Wynaan/XES/Programmation Projet/Sprite Image Files/Tileset_40px_packed.png

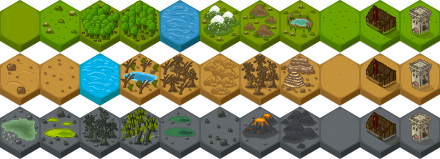
Programmation Projet/Sprite Image Files/Tileset_40px_packed.png
