Wynaan/XES/README.md

# XES

This repository details my end of degree project in Electronics Technology at Cegep Saint-Jean-sur-Richelieu.
