Wynaan/XES/Conception Files/Expansion Board/expansion_board_rev1/botlayer.png

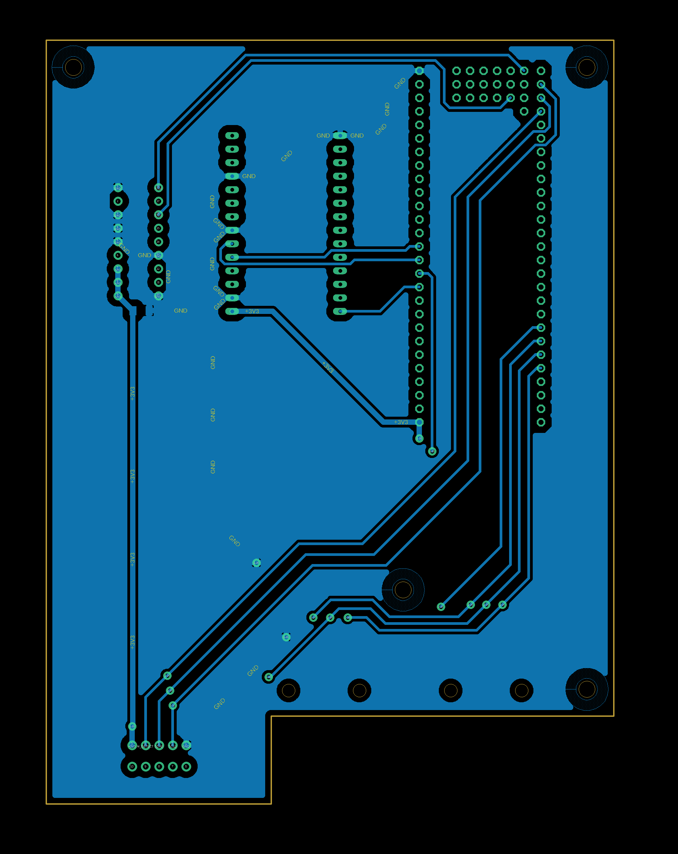
Conception Files/Expansion Board/expansion_board_rev1/botlayer.png
