Wynaan/XES/Conception Files/Expansion Board/expansion_board_rev1/placementbot.png

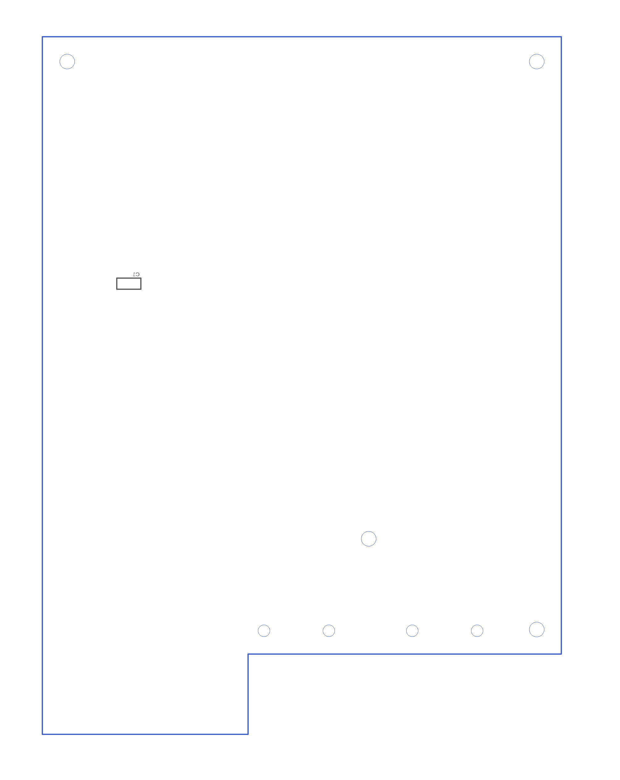
Conception Files/Expansion Board/expansion_board_rev1/placementbot.png
