Wynaan/XES/Conception Files/Expansion Board/expansion_board_rev1/schematic.png

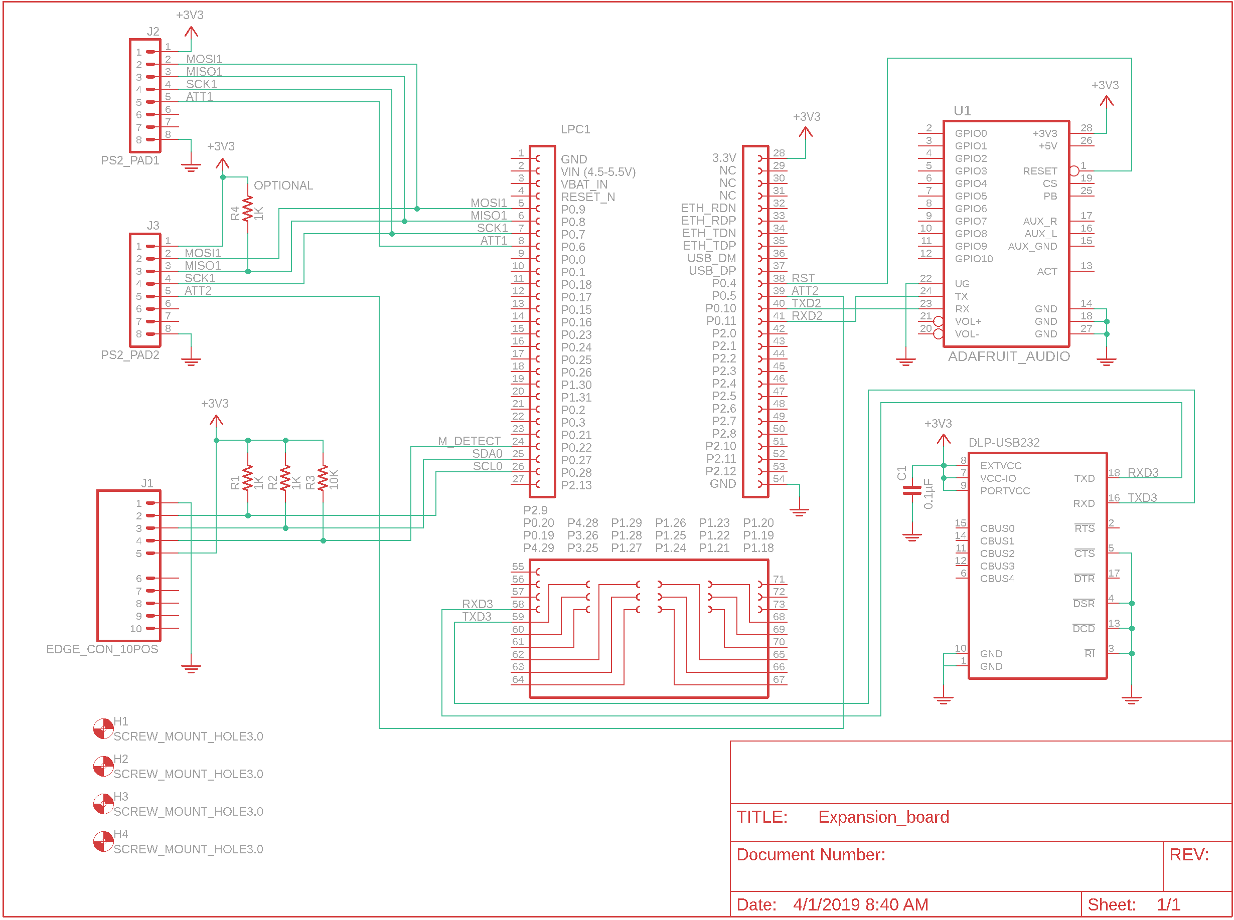
Conception Files/Expansion Board/expansion_board_rev1/schematic.png
