Wynaan/XES/Conception Files/Expansion Board/expansion_board_rev1/toplayer.png

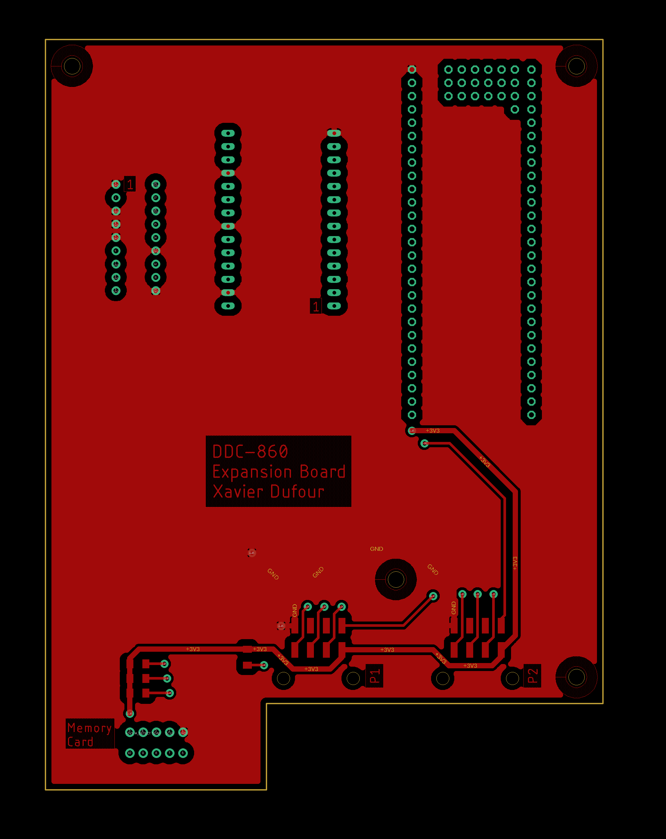
Conception Files/Expansion Board/expansion_board_rev1/toplayer.png
