Wynaan/XES/Conception Files/Expansion Board/expansion_board_rev1/topplacement.png

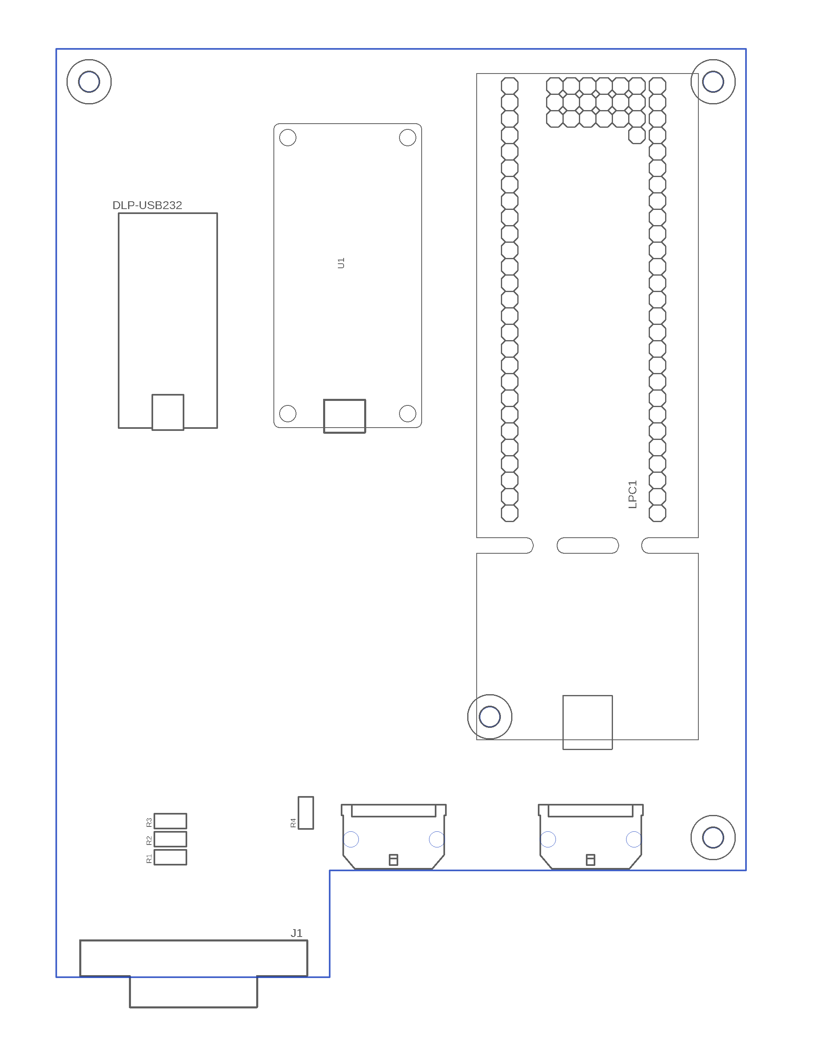
Conception Files/Expansion Board/expansion_board_rev1/topplacement.png
