Wynaan/XES/Conception Files/Memory Card/MemoryCardrev3/placementtop.png

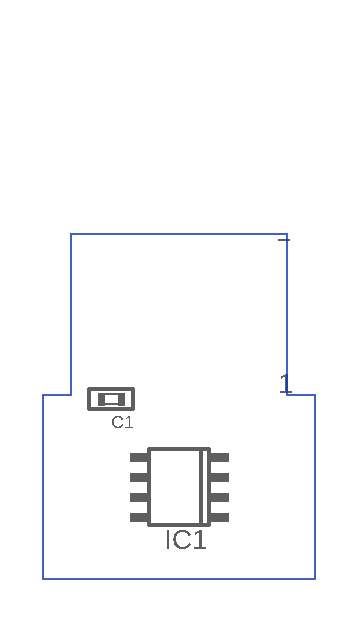
Conception Files/Memory Card/MemoryCardrev3/placementtop.png
