Wynaan/XES/Conception Files/Memory Card/MemoryCardrev3/schema.png

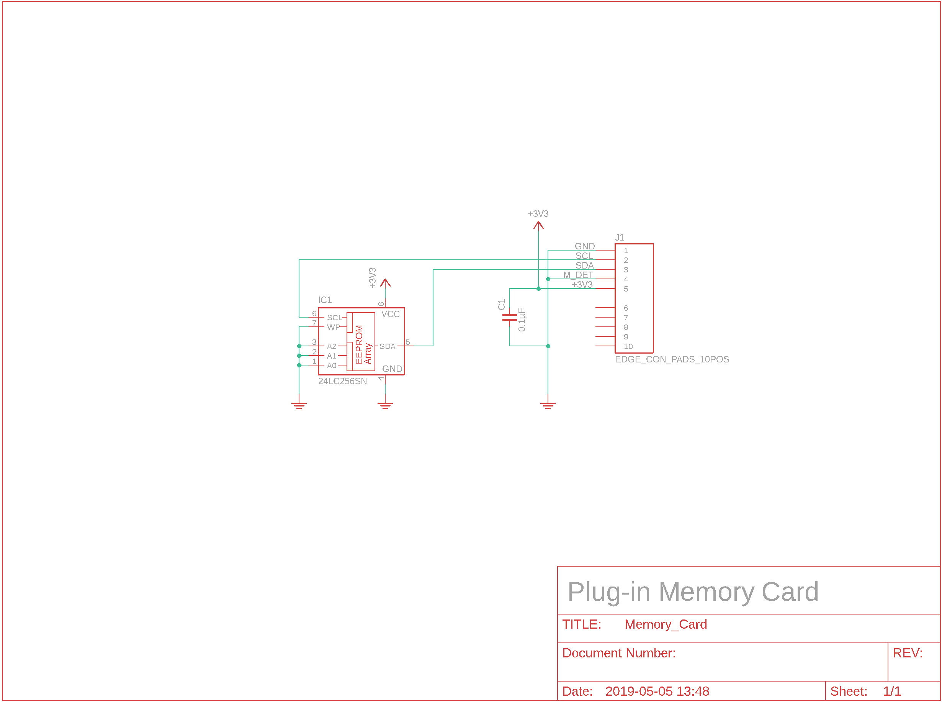
Conception Files/Memory Card/MemoryCardrev3/schema.png
