Wynaan/XES/Conception Files/Memory Card/MemoryCardrev3/toplayer.png

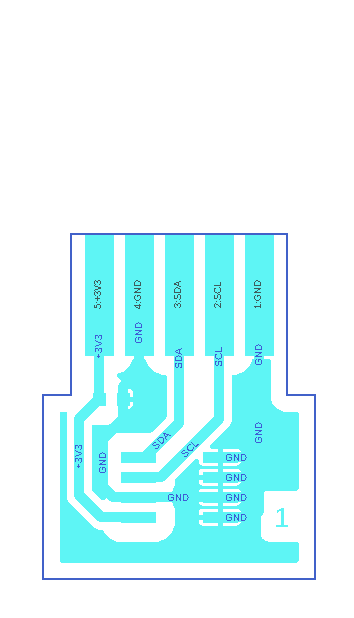
Conception Files/Memory Card/MemoryCardrev3/toplayer.png
