Wynaan/XES/Conception Files/Multisheet Schematic/botlayer.png

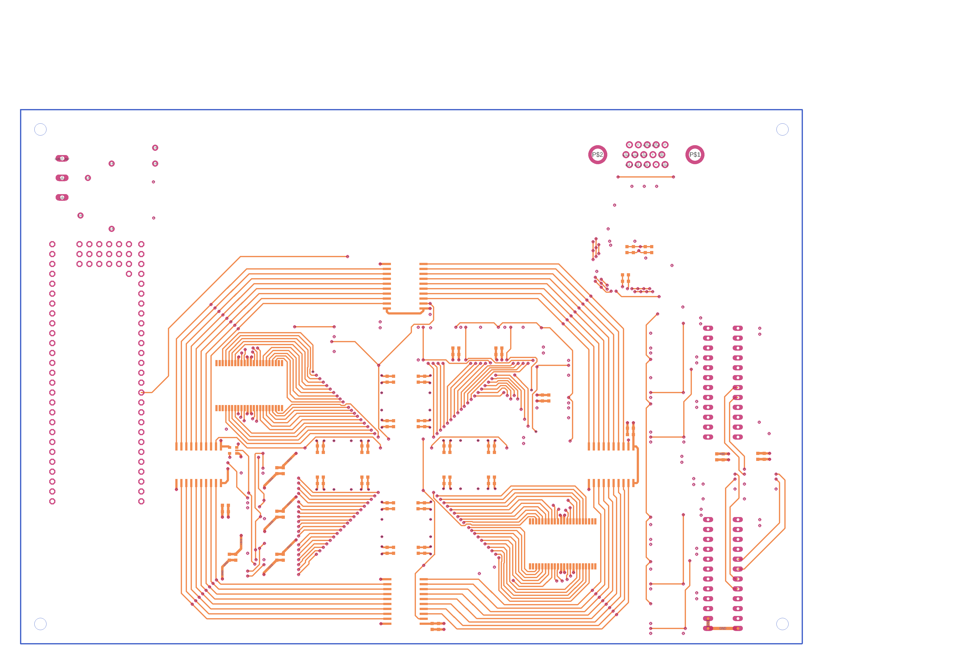
Conception Files/Multisheet Schematic/botlayer.png
