Wynaan/XES/Conception Files/Multisheet Schematic/gndlayer.png

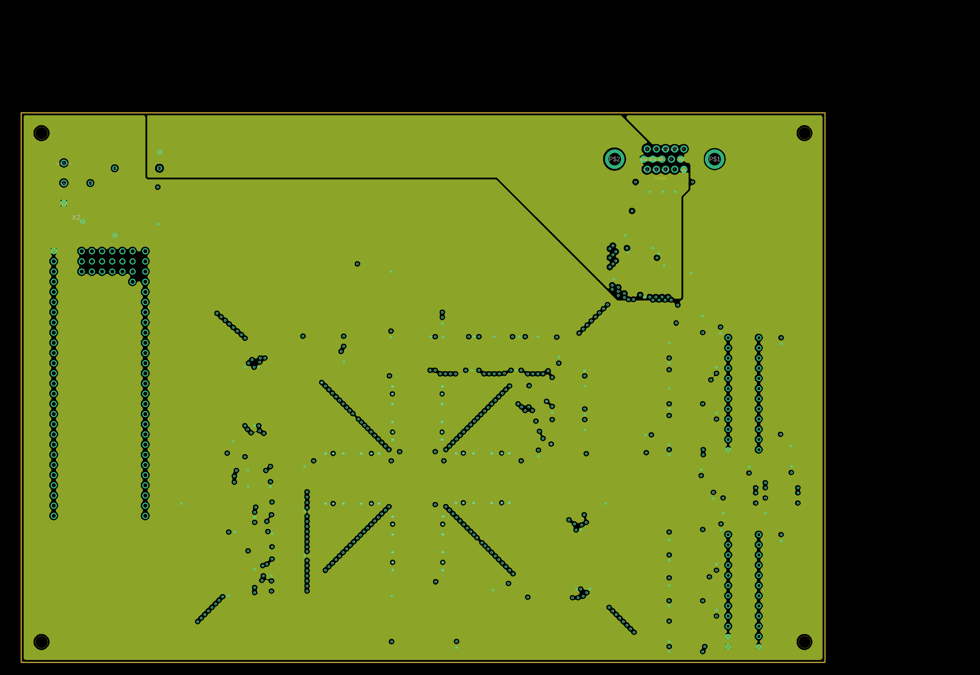
Conception Files/Multisheet Schematic/gndlayer.png
