Wynaan/XES/Conception Files/Multisheet Schematic/page1.png

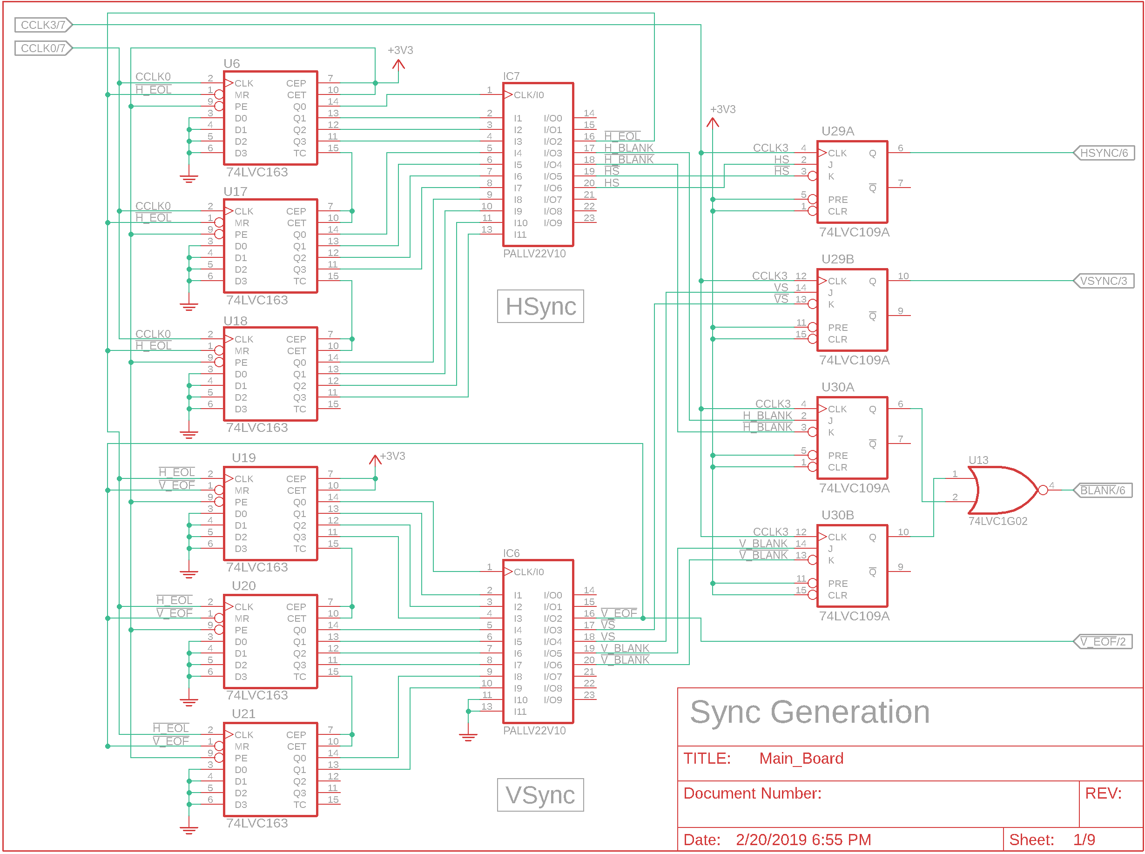
Conception Files/Multisheet Schematic/page1.png
