Wynaan/XES/Conception Files/Multisheet Schematic/page2.png

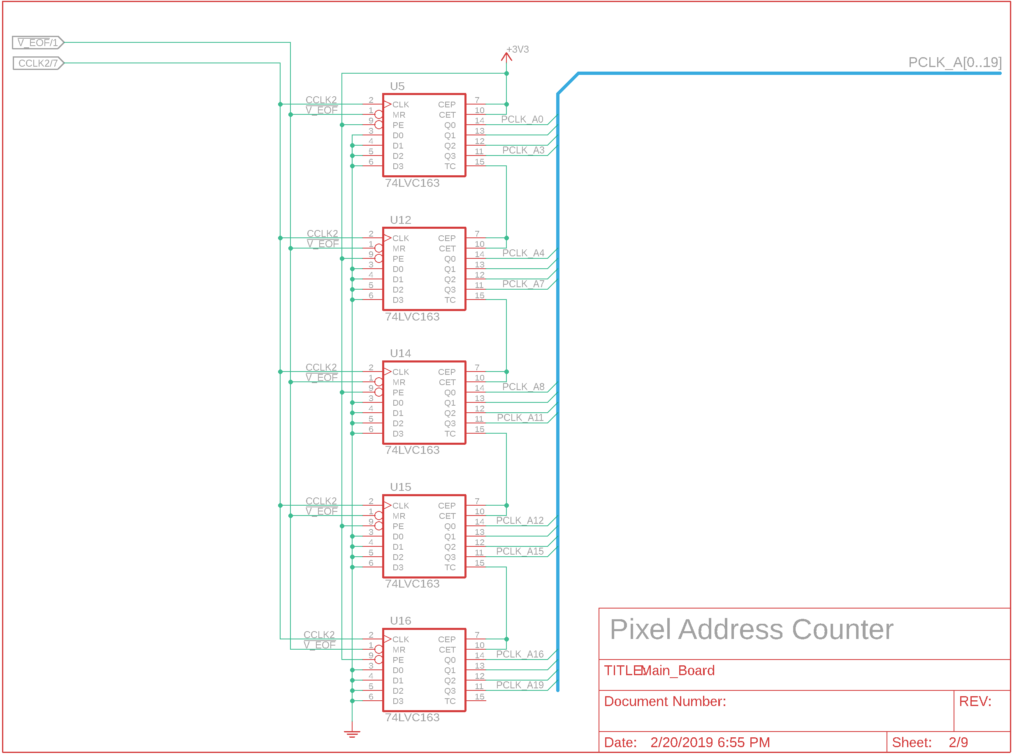
Conception Files/Multisheet Schematic/page2.png
