Wynaan/XES/Conception Files/Multisheet Schematic/page3.png

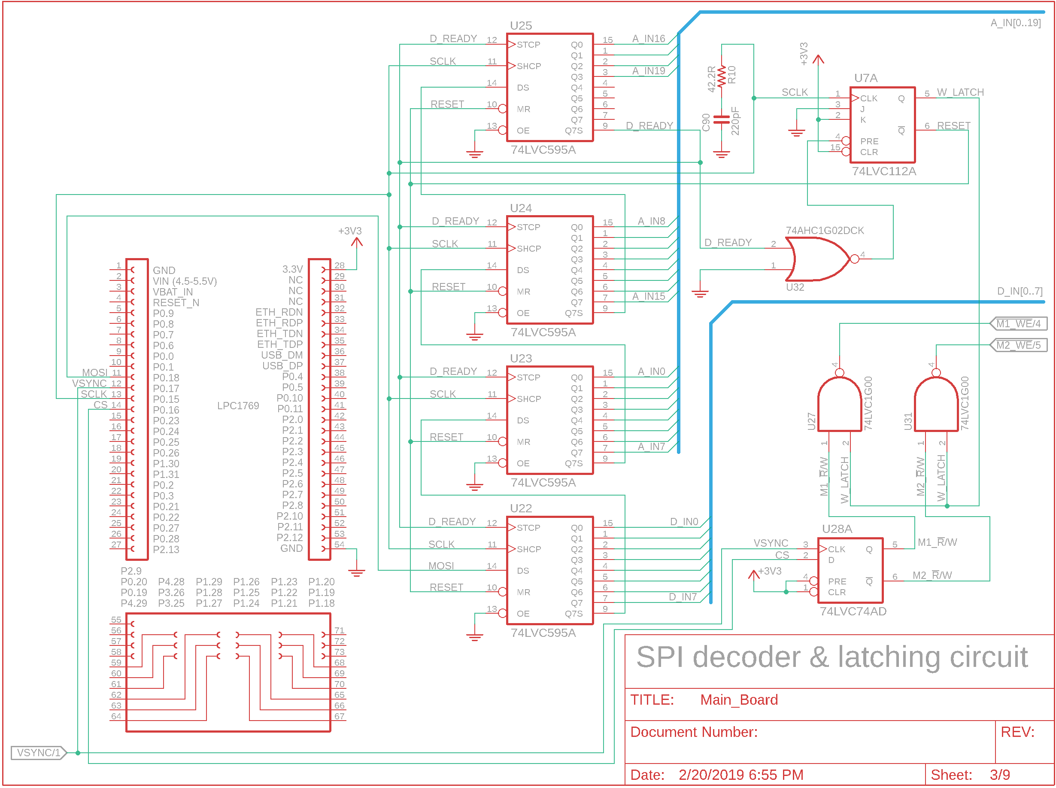
Conception Files/Multisheet Schematic/page3.png
