Wynaan/XES/Conception Files/Multisheet Schematic/page4.png

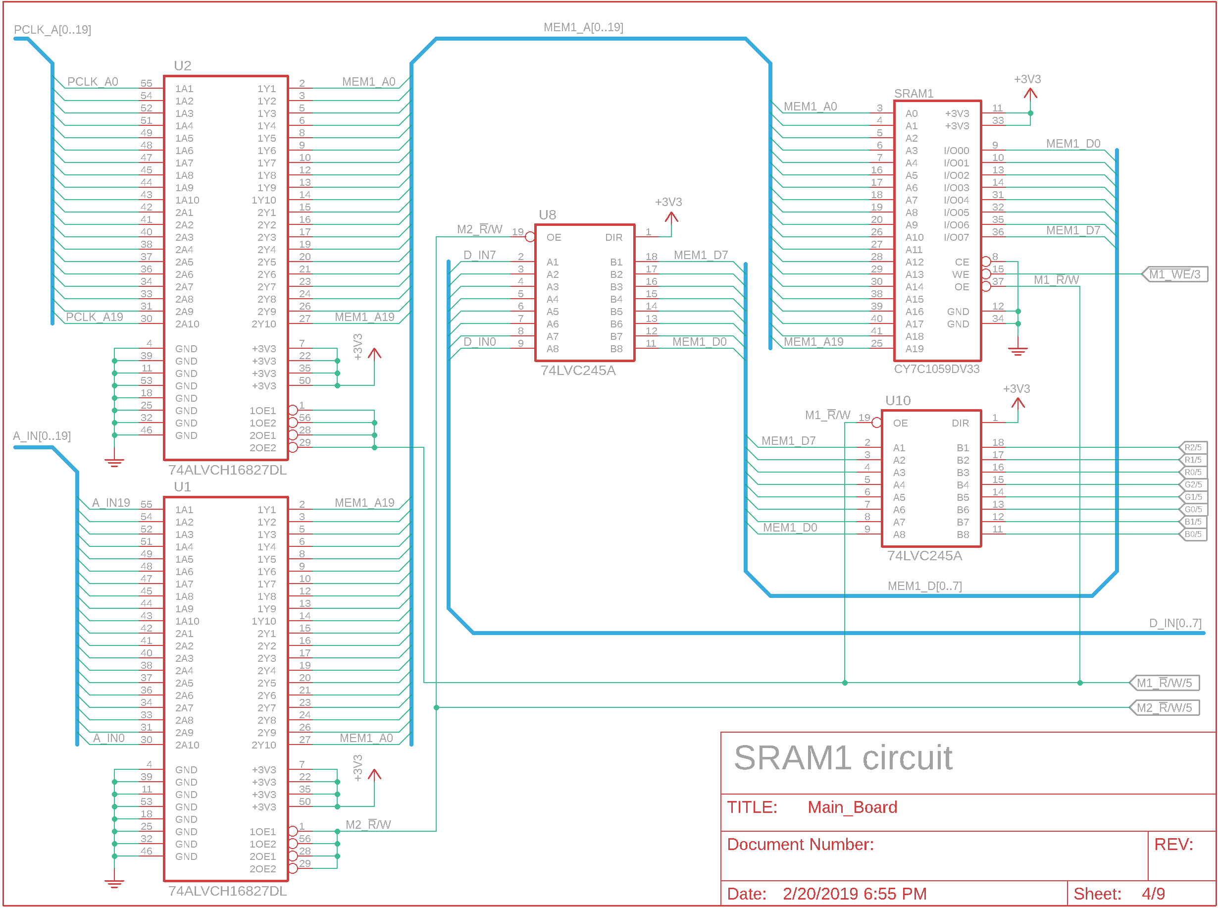
Conception Files/Multisheet Schematic/page4.png
