Wynaan/XES/Conception Files/Multisheet Schematic/page5.png

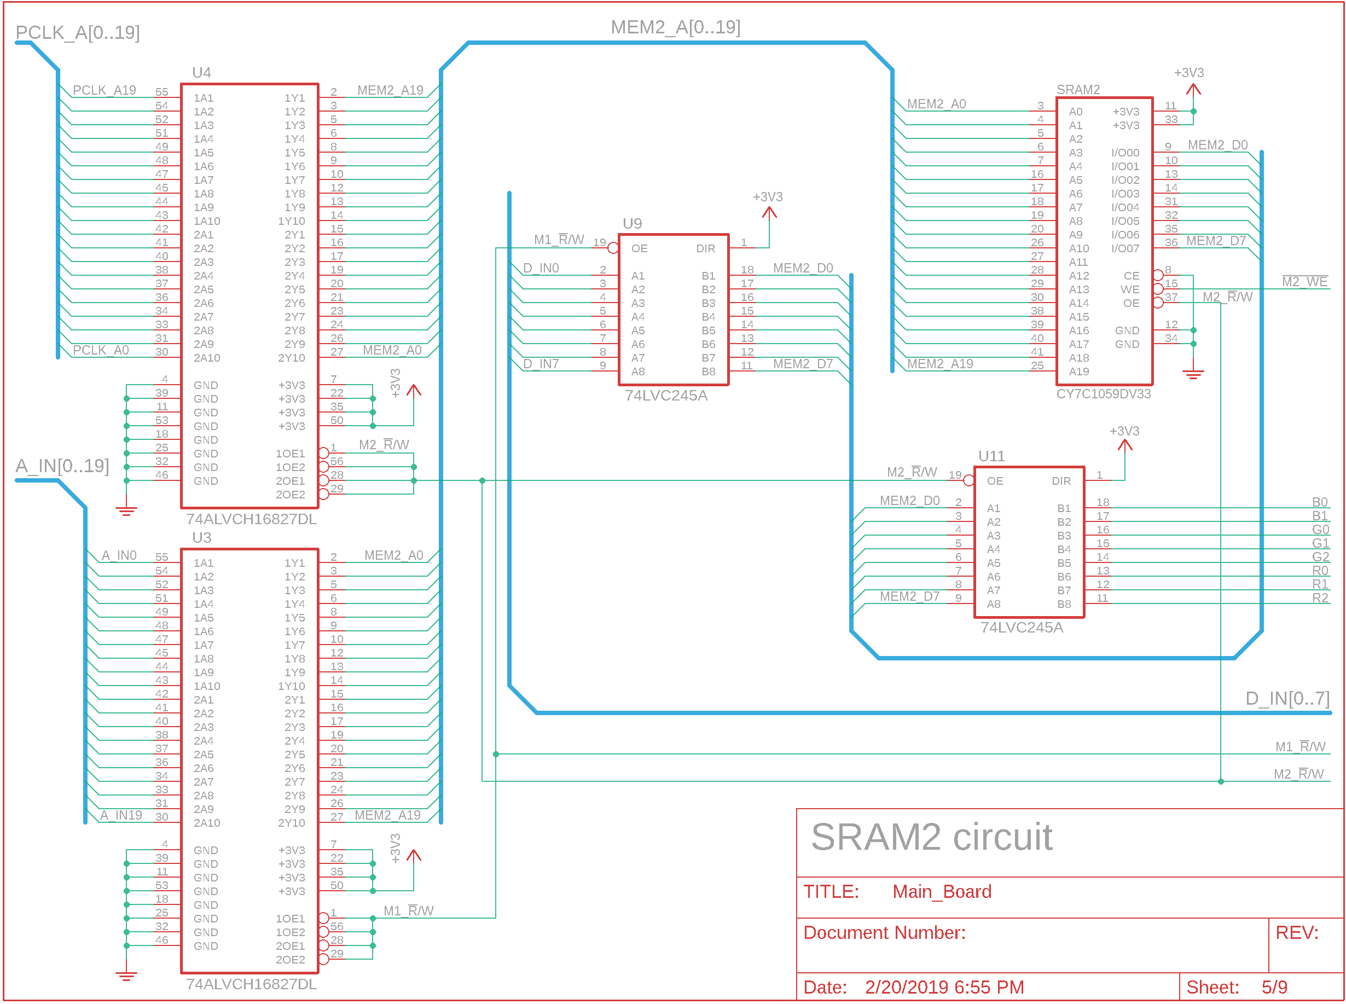
Conception Files/Multisheet Schematic/page5.png
