Wynaan/XES/Conception Files/Multisheet Schematic/page6.png

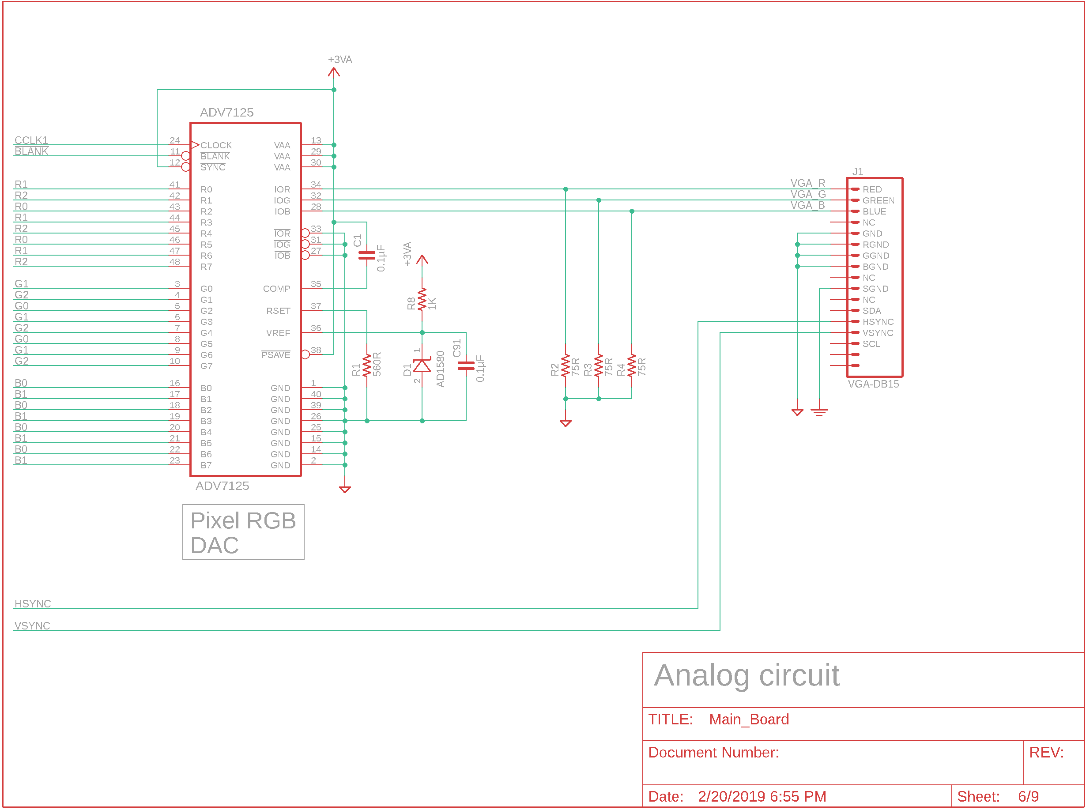
Conception Files/Multisheet Schematic/page6.png
