Wynaan/XES/Conception Files/Multisheet Schematic/page7.png

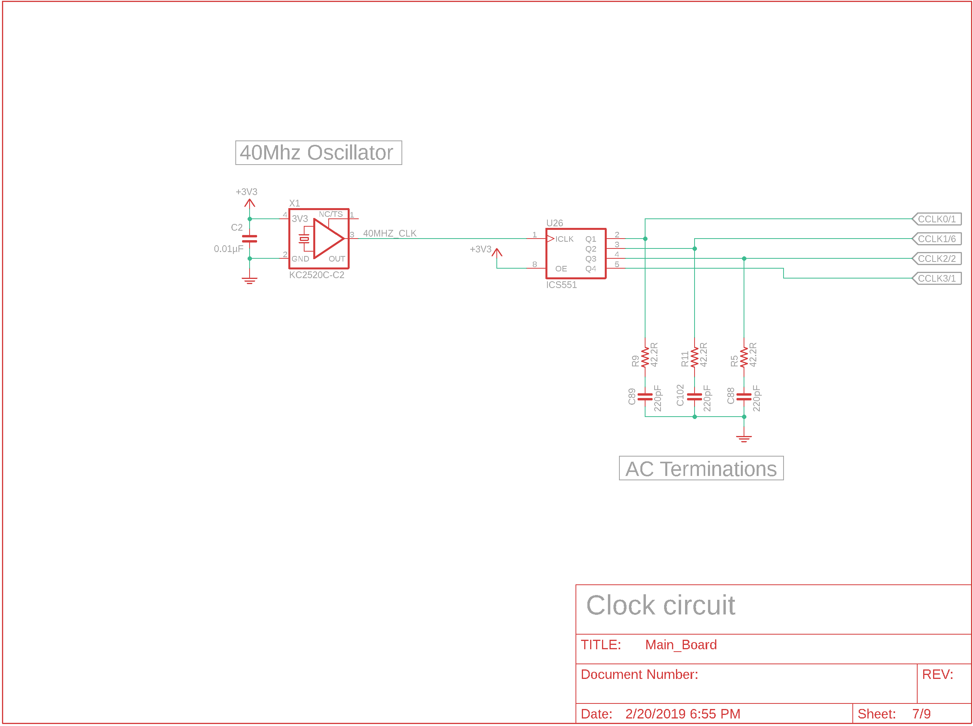
Conception Files/Multisheet Schematic/page7.png
