Wynaan/XES/Conception Files/Multisheet Schematic/page8.png

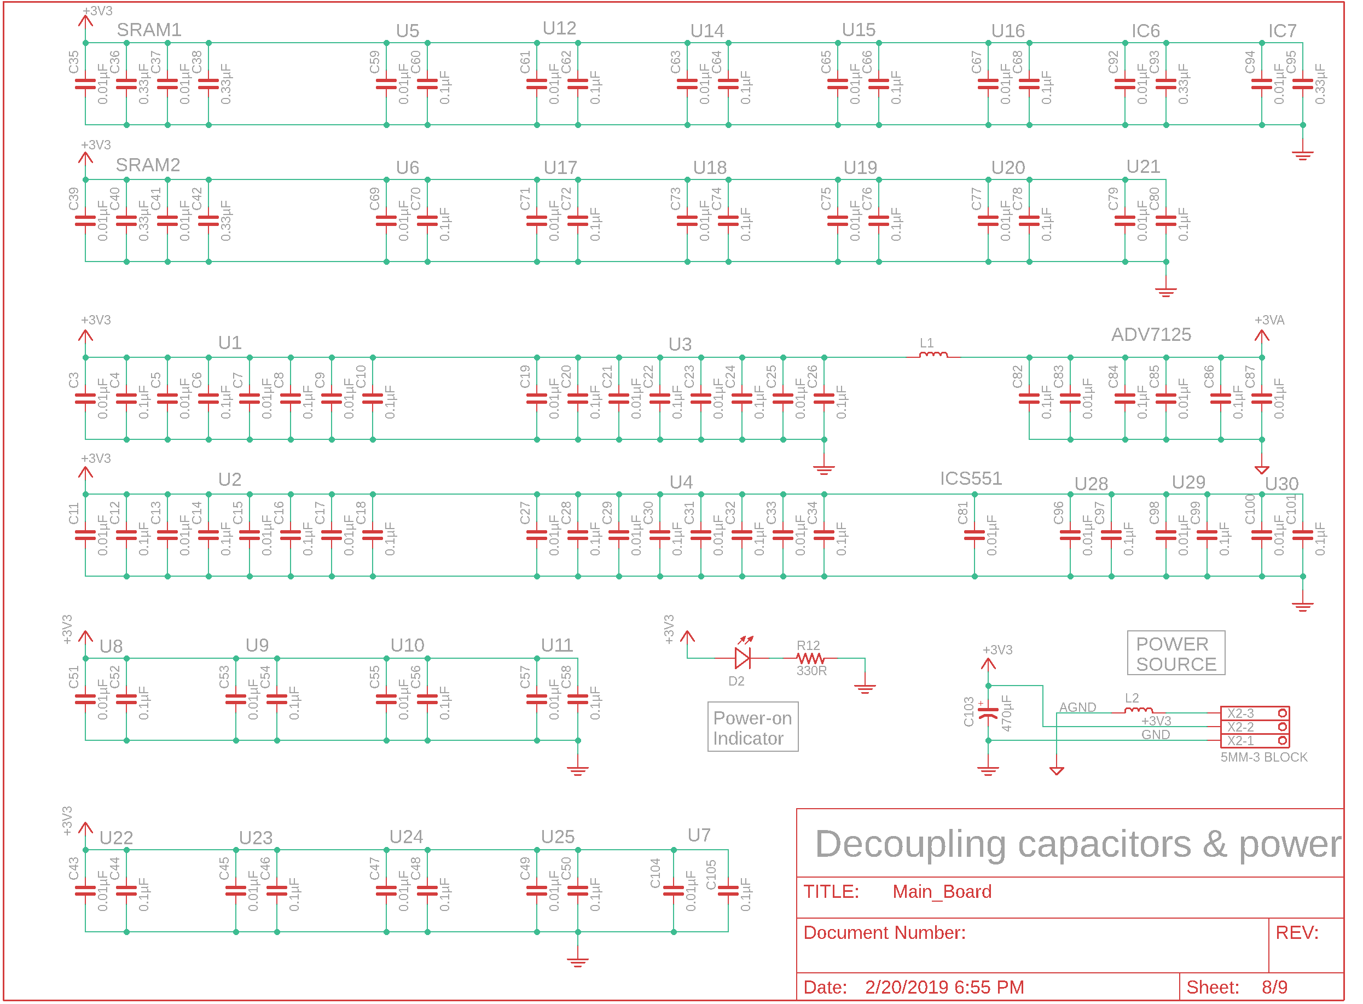
Conception Files/Multisheet Schematic/page8.png
