Wynaan/XES/Conception Files/Multisheet Schematic/page9.png

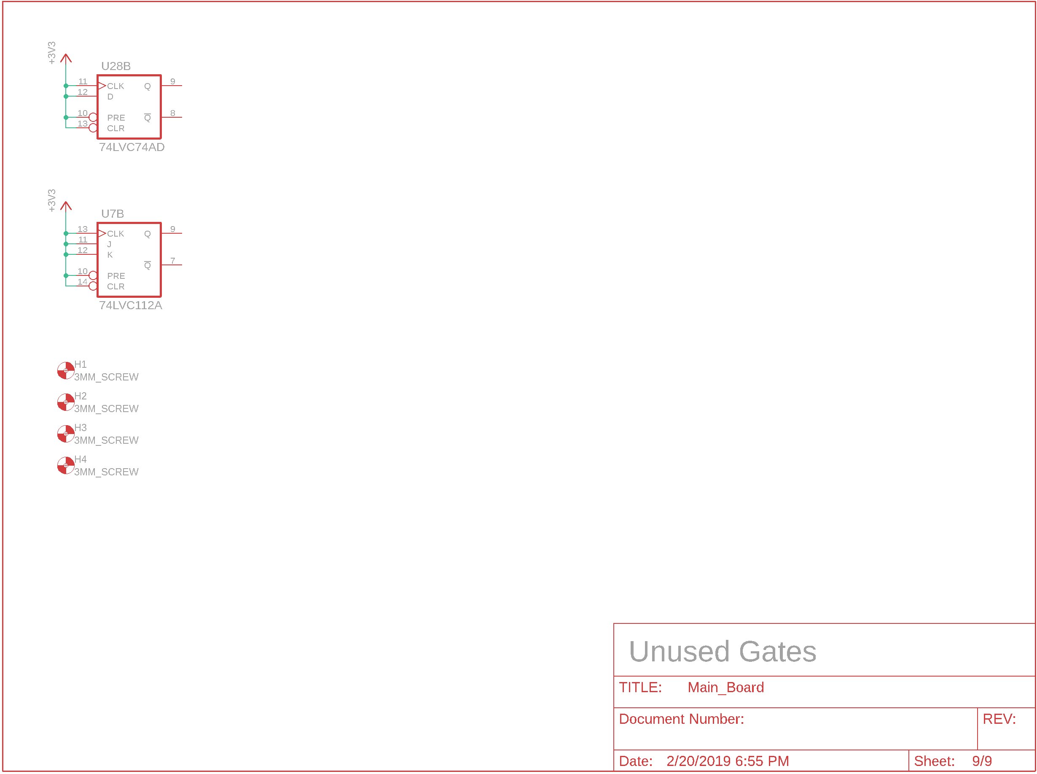
Conception Files/Multisheet Schematic/page9.png
