Wynaan/XES/Conception Files/Multisheet Schematic/placementbot.png

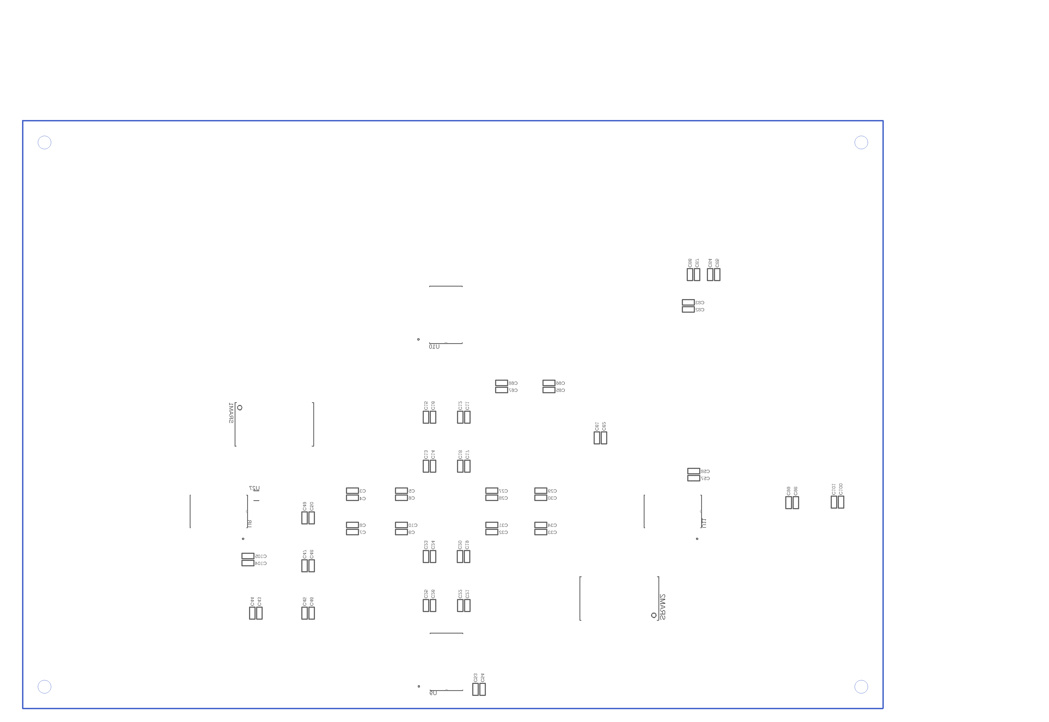
Conception Files/Multisheet Schematic/placementbot.png
