Wynaan/XES/Conception Files/Multisheet Schematic/placementtop.png

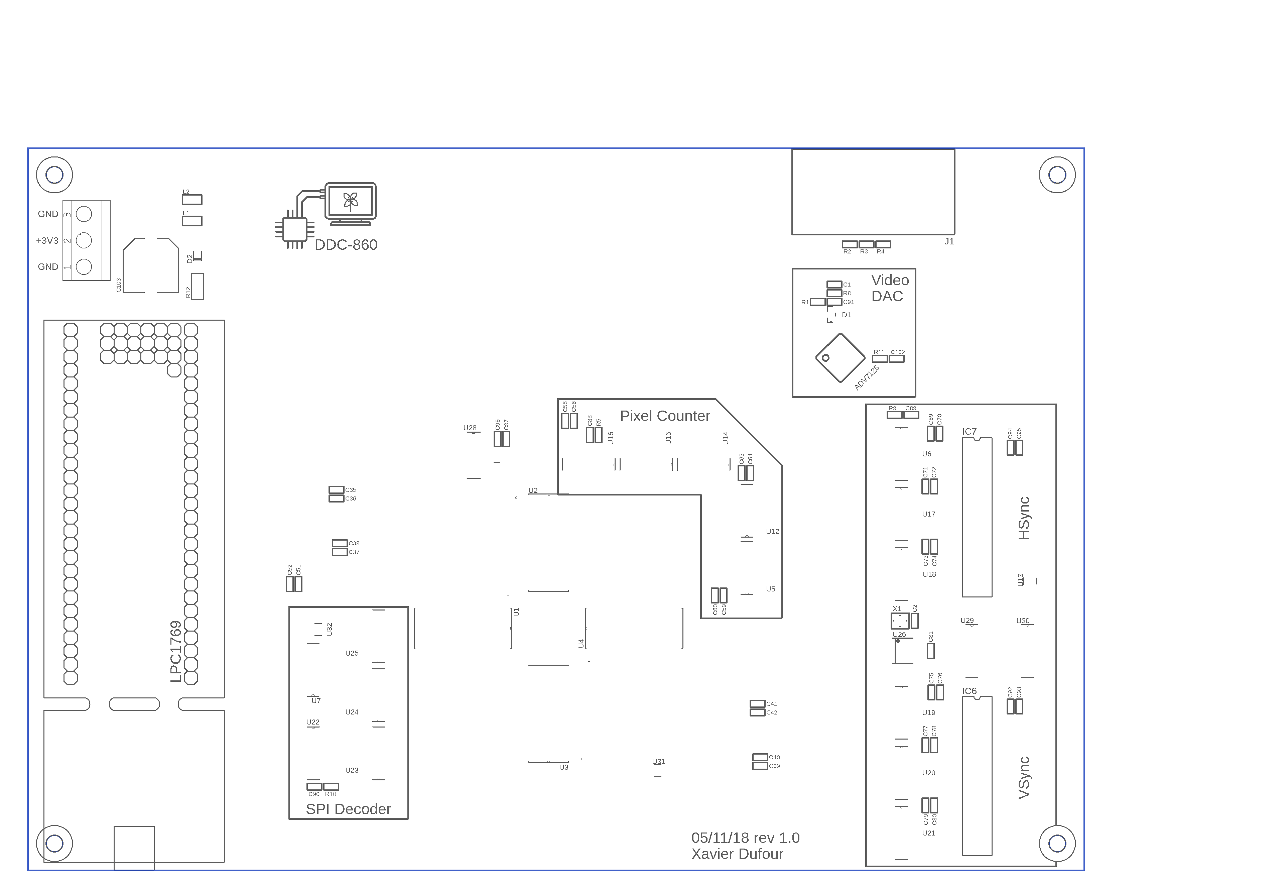
Conception Files/Multisheet Schematic/placementtop.png
