Wynaan/XES/Conception Files/Multisheet Schematic/toplayer.png

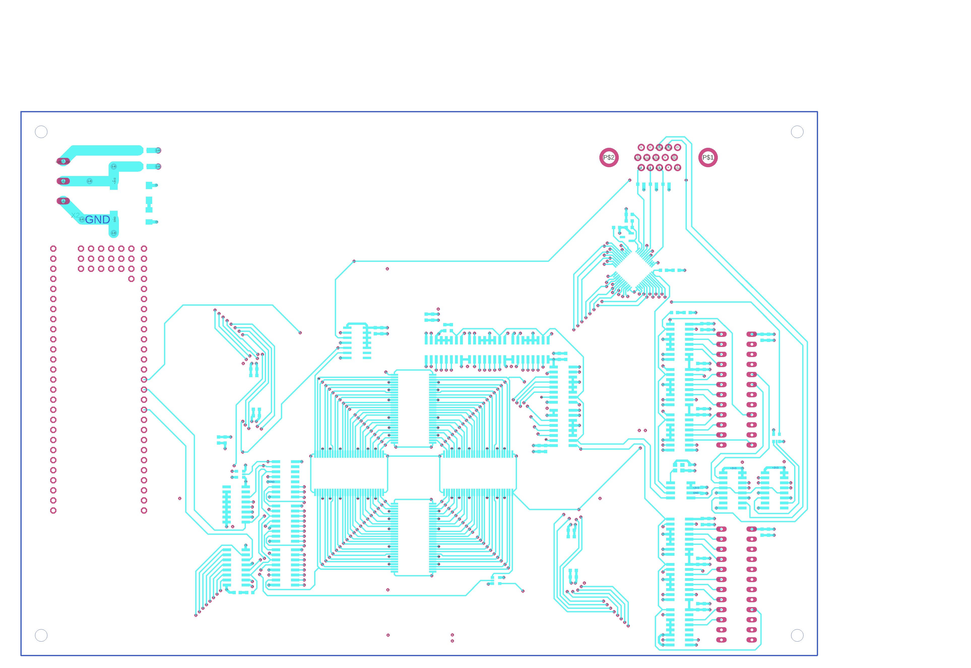
Conception Files/Multisheet Schematic/toplayer.png
