Wynaan/XES/Documentation/Croquis synoptique.png

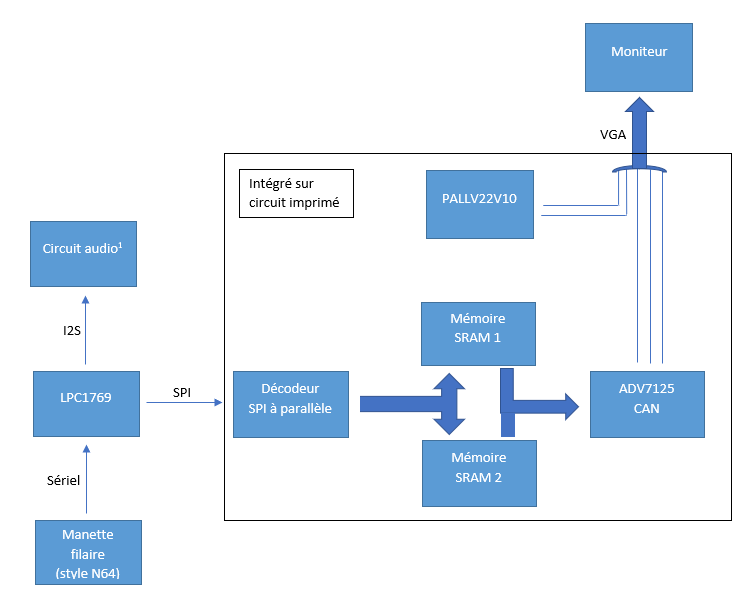
Documentation/Croquis synoptique.png
