Wynaan/XES/Documentation/Références/Capacitor Package Value Limits.png

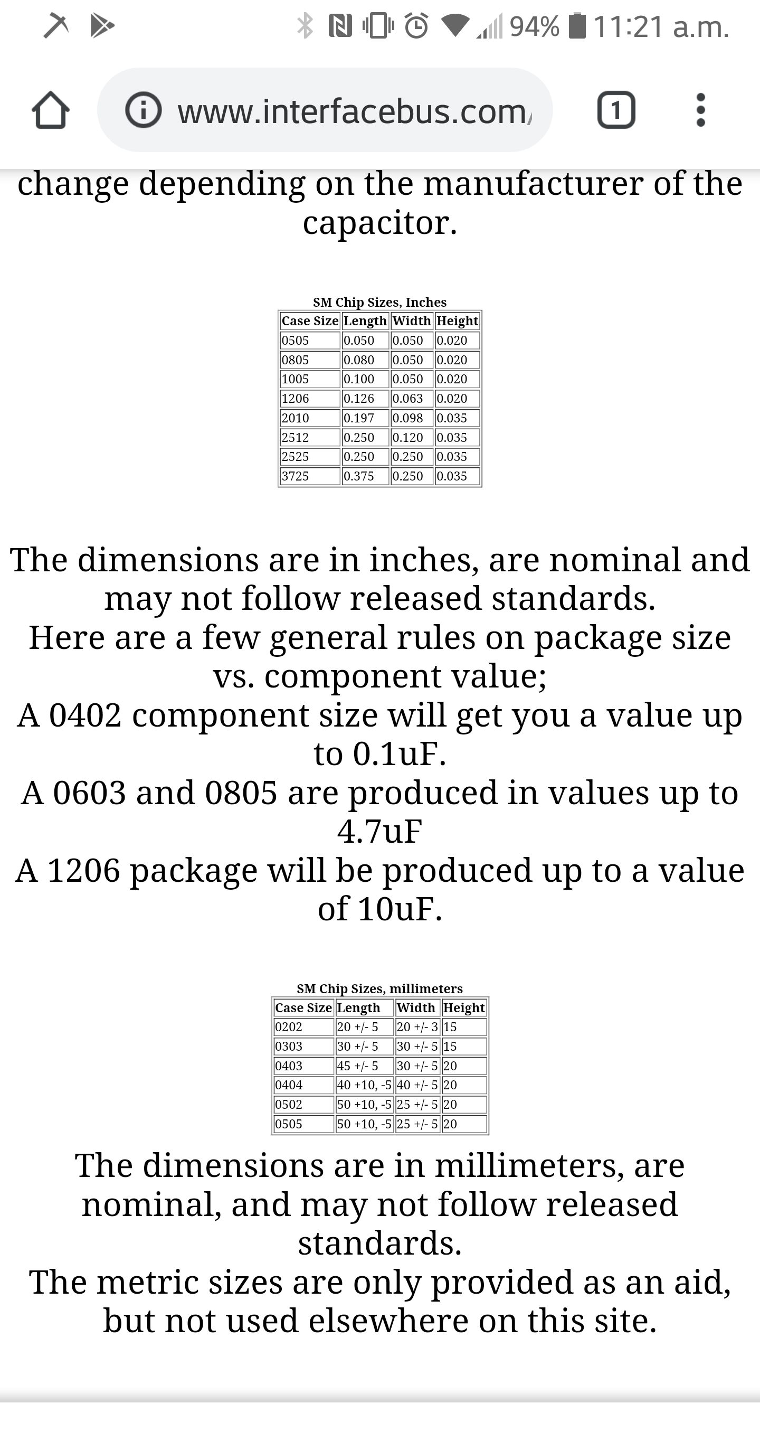
Documentation/Références/Capacitor Package Value Limits.png
