Wynaan/XES/Documentation/Références/SMD Package Size.png

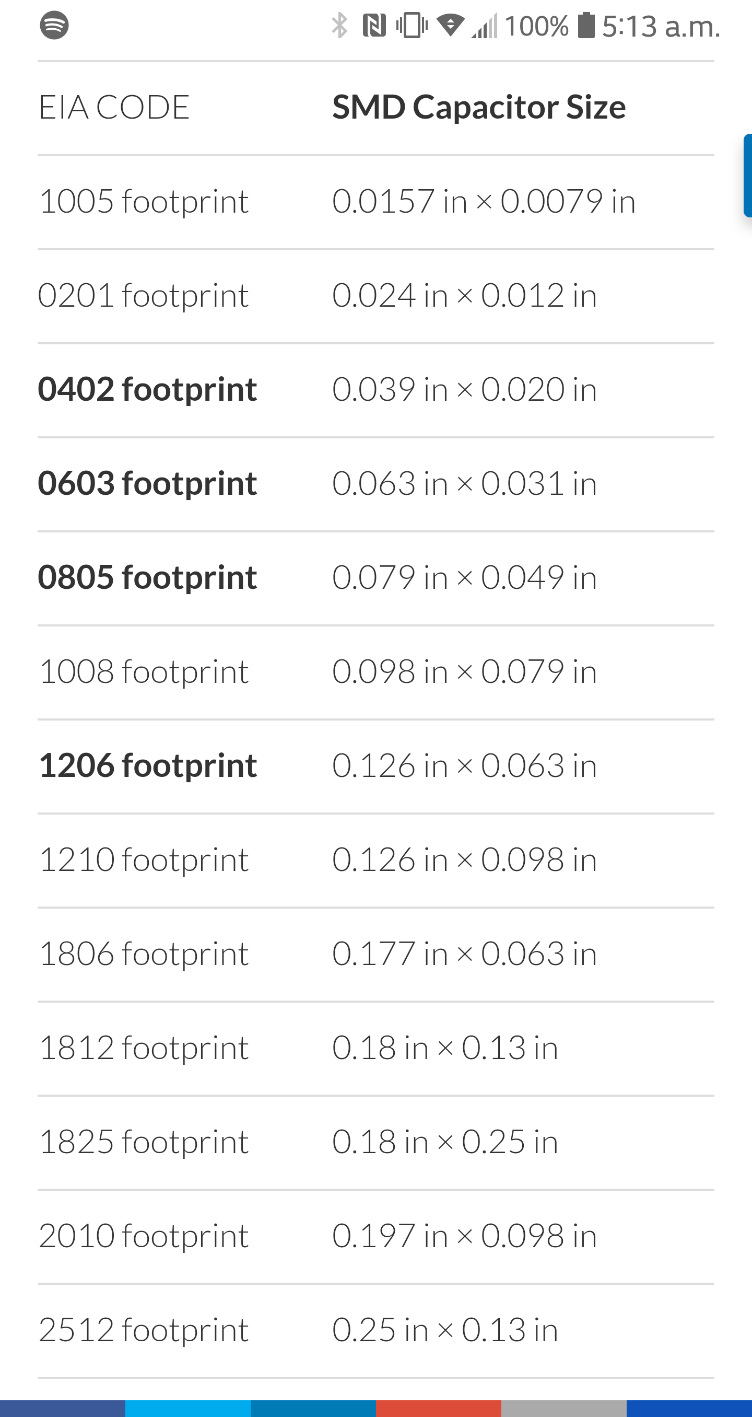
Documentation/Références/SMD Package Size.png
