Wynaan/XES/Documentation/Timing_diagram.png

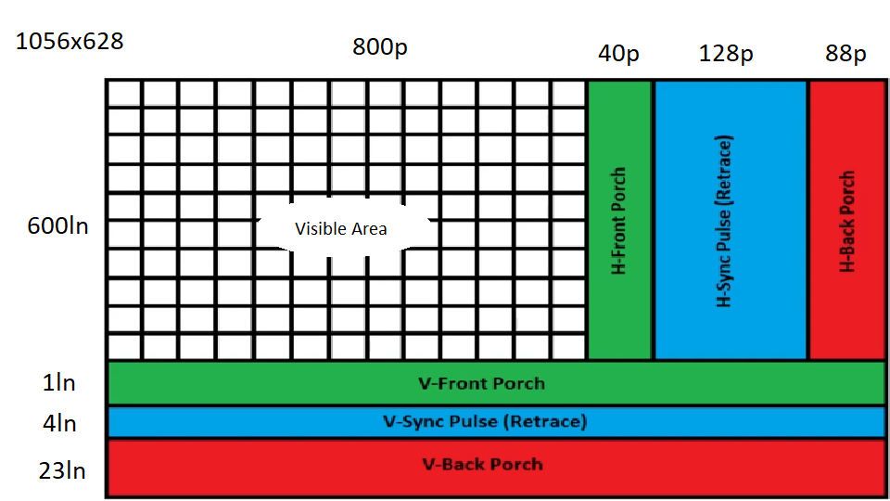
Documentation/Timing_diagram.png
