Wynaan/XES/Documentation/BOM.xlsx

Qty | Value | Device | Package | Parts | Description
50 | 0.01µF | GCM188R72A103KA37J | C0603 | C2, C3, C5, C7, C9, C11, C13, C15, C17, C19, C21, C23, C25, C27, C29, C31, C33, C35, C37, C39, C41, C43, C45, C47, C49, C51, C53, C55, C57, C59, C61, C63, C65, C67, C69, C71, C73, C75, C77, C79, C81, C83, C85, C87, C92, C94, C96, C98, C100, C104 | SMD Ceramic non-polarized capacitor
44 | 0.1µF | CC0603KRX7R7BB104 | C0603 | C1, C4, C6, C8, C10, C12, C14, C16, C18, C20, C22, C24, C26, C28, C30, C32, C34, C44, C46, C48, C50, C52, C54, C56, C58, C60, C62, C64, C66, C68, C70, C72, C74, C76, C78, C80, C82, C84, C86, C91, C97, C99, C101, C105 | SMD Ceramic non-polarized capacitor
11 |  | 74LVC163D | SO16(SOT109) | U5, U6, U12, U14, U15, U16, U17, U18, U19, U20, U21 | 4-bit synchronous counter with RCO output
6 | 0.33µF | GRM188R71C334KA01D | C0603 | C36, C38, C40, C42, C93, C95 | SMD Non-polarized capacitor
4 | 42.2R | RP73PF1J42R2BTDF | R0603 | R5, R9, R10, R11 | SMD Resistor 0.1%
4 |  | 74ALVCH16827DL | SSOP56(SOT371) | U1, U2, U3, U4 | 20-bit buffer/driver with 3-state outputs
4 |  | 74LVC245AD | SO20W(SOT163) | U8, U9, U10, U11 | Octal bus transceiver with 3-state outputs
4 |  | 74LVC595AD | SO16(SOT109) | U22, U23, U24, U25 | 8-bit serial-in/serial-out or parallel-out shift register with 3-state ouput
3 | 220pF | C0603C221K2RACTU | C0603 | C88, C89, C90, C102 | SMD Ceramic non-polarized capacitor
3 | 75R | RNCP0603FTD75R0 | R0603 | R2, R3, R4 | SMD Resistor 1%
2 |  | 74LVC109A | SO16(SOT109) | U29, U30 | Dual JK Latch, positive edge triggered
2 |  | 74LVC1G00GW | SC70-5(SOT353) | U27, U31 | Single NOR gate
2 |  | CY7C1059DV33-10ZSXI | TSOPII-44 | SRAM1, SRAM2 | 1M x 8bit Asynchronous SRAM
2 |  | 742792097 | L0805 | L1, L2 | Ferrite bead 1.5KOhm
1 | 330R | CRCW0805330RFKEAC | R1206 | R12 | SMD Resistor 1%
1 |  | QBLP615-IG | D1206 | D2 | Light Emitting Diode
1 | 1K | RR0816P-102-D | R0603 | R8 | SMD Resistor
1 | 470µF | UWT1E471MNL1GS | Radial 10mm SMD | C103 | SMD Electrolytic polarized capacitor
1 | 560R | AC0603FR-07560RL | R0603 | R1 | SMD Resistor
1 |  | 74AHC1G02DCKR | SC70-5(SOT353) | IC5 | Single NOR gate
1 |  | 74LVC112AD | SO16(SOT109) | U7 | Dual JK Latch, negative edge triggered
1 |  | 74LVC1G02DCKR | SC70-5(SOT353) | U13 | Single NOR gate
1 |  | 74LVC74AD | SO14(SOT108) | U28 | Dual D Latch, positive edge triggered
1 |  | AD1580BRTZ | SOT23 | D1 | 1.2 V Micropower, Precision 1.2 V Micropower, Precision
1 |  | ADV7125JSTZ330 | LQFP48 | ADV7125 | triple 8-bit 3.3V high speed video DAC, 330MHz grade
1 |  | ICS551 | SO8(SOT96) | U26 | Clock fanout buffer 1 to 4, 160MHz with 3-state outputs
1 |  | KC2520C40.0000C2YE00 | 2.5X2.0_KXO-V95 | X1 | SMD crystal oscillator
1 |  | LS25-3.3 | LS25-3.3 |  | Power supply 120VAC to 3.3VDC, 6A
1 |  | SCREW_BLOCK | SCREW_BLOCK5-3PIN | J2 | Screw terminal block 5mm spacing 3-pins
1 |  | 9561525613 | DB15-VGA-90DEG | J1 | DB-15 connector for VGA, 90 degrees
