Wynaan/XES/Conception Files/Expansion Board/Expansion_board.brd

## EAGLE design Conception Files/Expansion Board/Expansion_board.brd (2020-03-08)

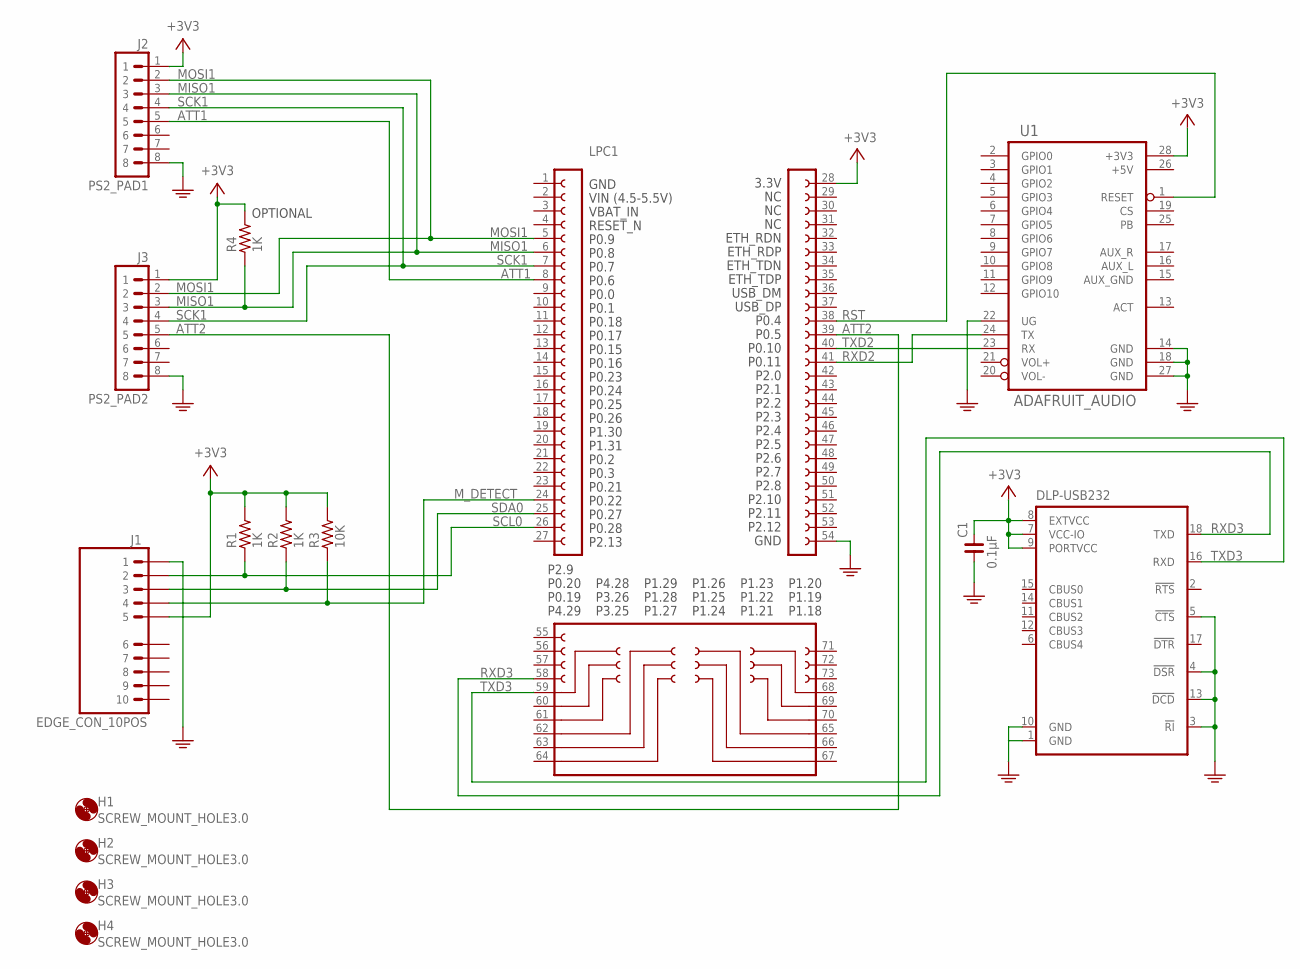
[picture p41: schematic Expansion_board.sch]

Parts:
C1: 0.1µF; C1206
H1, H2, H3, H4: SCREW_MOUNT_HOLE3.0; 3MM_HOLE
J1: EDGE_CON_10POS
J2: PS2_PAD1; MOLEX43045_0806
J3: PS2_PAD2; MOLEX43045_0806
LPC1: LPCXPRESSO_LPC1769
R1, R2, R4: 1K; R1206
R3: 10K; R1206
U1: ADAFRUIT_AUDIO; AUDIO_FX_SOUND_BOARD
U$1: DLP-USB232

Connections:
+3V3: C1.2, J1.5, J2.1, J3.1, LPC1.28, R1.2, R2.2, R3.2, R4.2, U1.28 (+3V3), U$1.7 (VCC-IO), U$1.8 (EXTVCC), U$1.9 (PORTVCC)
ATT1: J2.5, LPC1.8
ATT2: J3.5, LPC1.39
GND: C1.1, J1.1, J2.8, J3.8, LPC1.54, U1.14 (GND), U1.18 (GND), U1.22 (UG), U1.27 (GND), U$1.1 (GND), U$1.3 (!RI), U$1.4 (!DSR), U$1.5 (!CTS), U$1.10 (GND), U$1.13 (!DCD)
MISO1: J2.3, J3.3, LPC1.6, R4.1
MOSI1: J2.2, J3.2, LPC1.5
M_DETECT: J1.4, LPC1.24, R3.1
RST: LPC1.38, U1.1 (RESET)
RXD2: LPC1.41, U1.24 (TX)
RXD3: LPC1.58, U$1.18 (TXD)
SCK1: J2.4, J3.4, LPC1.7
SCL0: J1.2, LPC1.26, R1.1
SDA0: J1.3, LPC1.25, R2.1
TXD2: LPC1.40, U1.23 (RX)
TXD3: LPC1.59, U$1.16 (RXD)

Notes on the sheet:
OPTIONAL

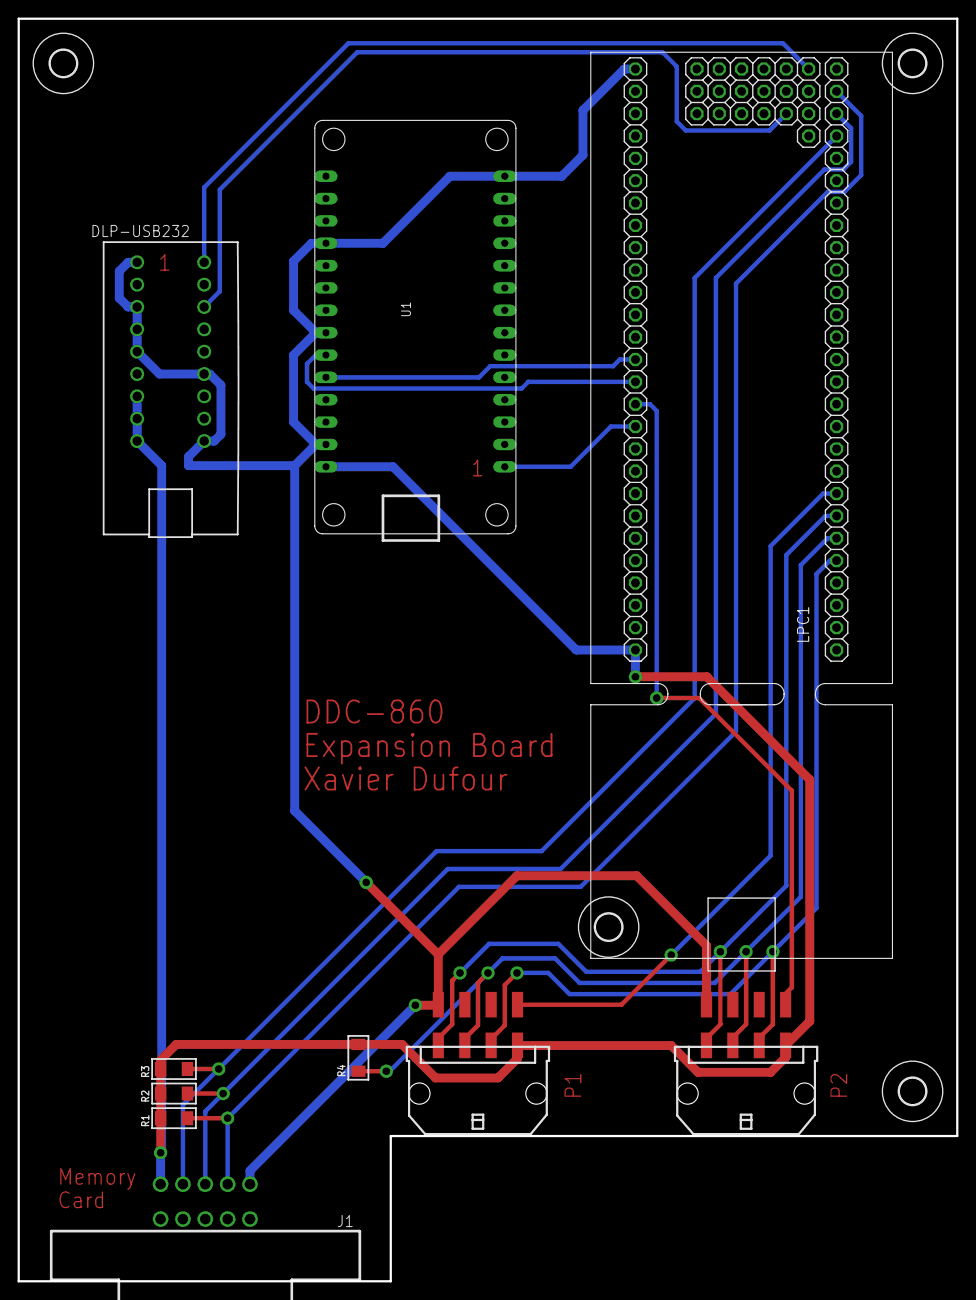
[picture p42: board Expansion_board.brd from above]

Board: 2 copper layers, 106.7 x 143.5 mm, 15 parts (1 on the bottom side), 15 nets.
