Wynaan/XES/Conception Files/VGA Test Board/VGA_Test_Board.brd

## EAGLE design Conception Files/VGA Test Board/VGA_Test_Board.brd (2020-03-08)

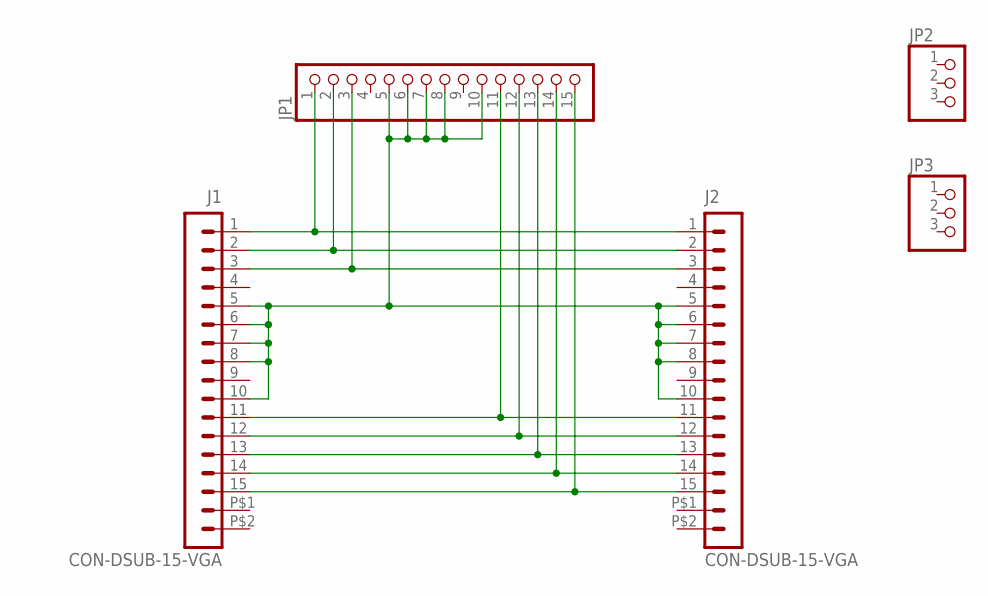
[picture p43: schematic VGA_Test_Board.sch]

Parts:
J1, J2: CON-DSUB-15-VGA; 181-015-212-171
JP1: PINHD-1X15; 1X15
JP2, JP3: PINHD-1X3; 1X03

Connections:
GND: J1.5, J1.6, J1.7, J1.8, J1.10, J2.5, J2.6, J2.7, J2.8, J2.10, JP1.5, JP1.6, JP1.7, JP1.8, JP1.10
unnamed: J1.1, J2.1, JP1.1
unnamed: J1.2, J2.2, JP1.2
unnamed: J1.3, J2.3, JP1.3
unnamed: J1.11, J2.11, JP1.11
unnamed: J1.12, J2.12, JP1.12
unnamed: J1.13, J2.13, JP1.13
unnamed: J1.14, J2.14, JP1.14
unnamed: J1.15, J2.15, JP1.15

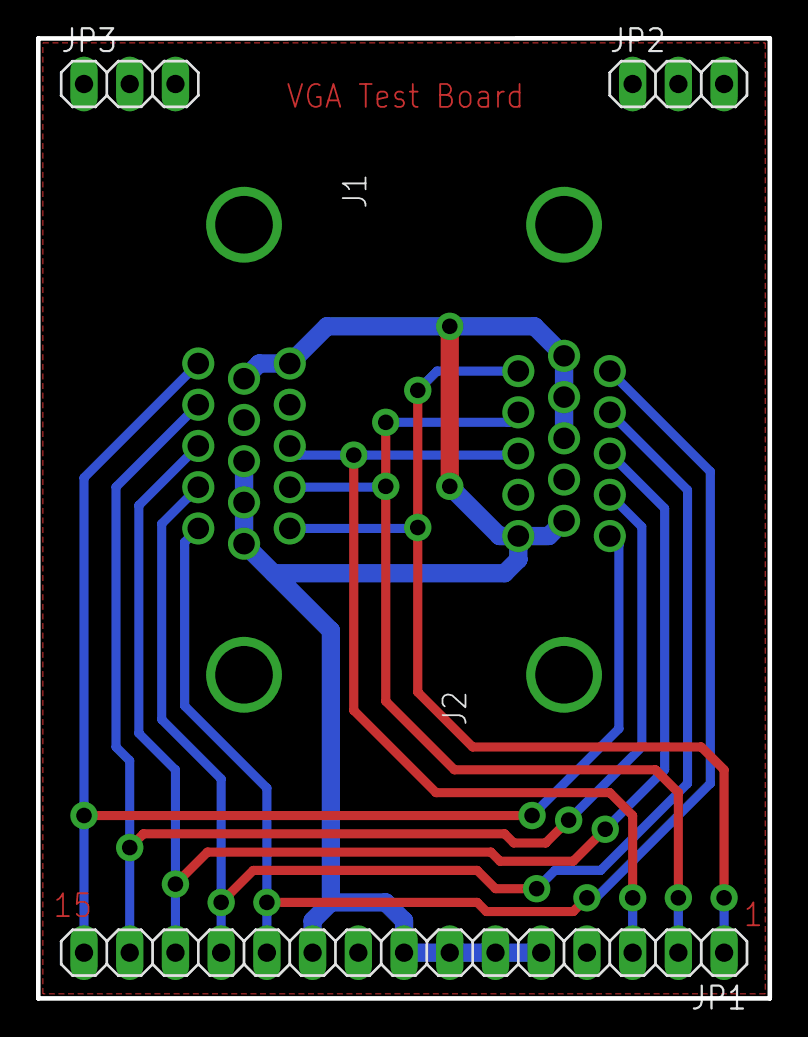
[picture p44: board VGA_Test_Board.brd from above]

Board: 2 copper layers, 40.6 x 53.3 mm, 5 parts (0 on the bottom side), 9 nets.
