Wynaan/XES/Conception Files/Memory Card/MemoryCardrev2/Memory_Card.brd

## EAGLE design Conception Files/Memory Card/MemoryCardrev2/Memory_Card.brd (2020-03-08)

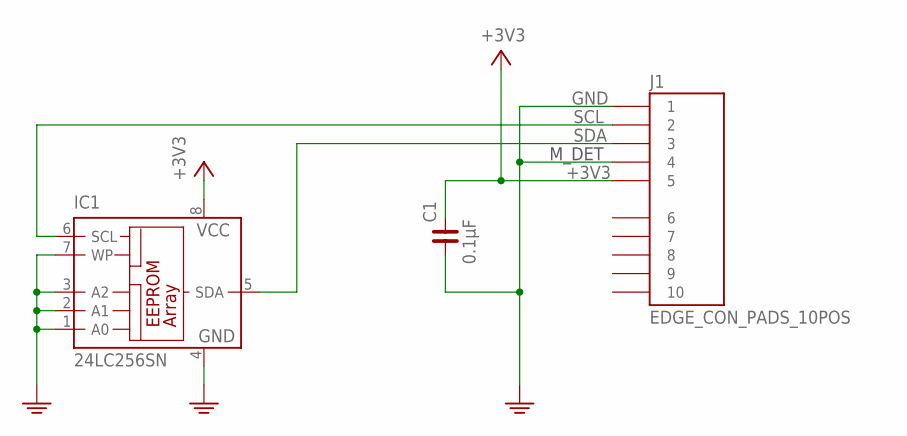
[picture p45: schematic Memory_Card.sch]

Parts:
C1: 0.1µF; C0603
IC1: 24LC256SN; SO-08
J1: EDGE_CON_PADS_10POS; EDGE_CON_PADS

Connections:
+3V3: C1.2, IC1.8 (VCC), J1.5
GND: C1.1, IC1.1 (A0), IC1.2 (A1), IC1.3 (A2), IC1.4 (GND), IC1.7 (WP), J1.1, J1.4
SCL: IC1.6 (SCL), J1.2
SDA: IC1.5 (SDA), J1.3

Notes on the sheet:
M_DET

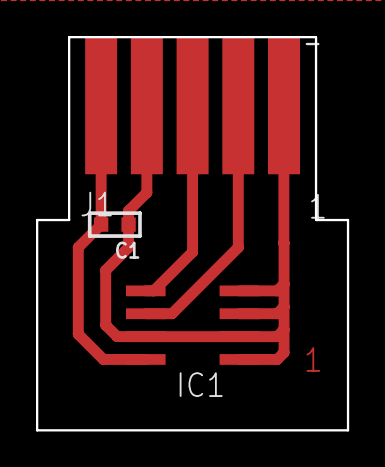
[picture p46: board Memory_Card.brd from above]

Board: 2 copper layers, 17.3 x 21.8 mm, 3 parts (0 on the bottom side), 4 nets.
